Nonnanaw/Real-Time-RFID-GPS-Asset-Tracking-System/README.md

# Real-Time-RFID-GPS-Asset-Tracking-System
Built an IoT tracking system with RFID check-in and GPS nodes, streaming JSON data via MQTT to Node-RED. 
Applied Haversine algorithm for distance tracking, achieving 4.66m average GPS accuracy.
